ewanuno/ms404_reverse_pot_adapter/ms404 pot adapter kicad project/ms404 pot adapter pcb.kicad_sch

## KiCad design ms404 pot adapter kicad project/ms404 pot adapter pcb.kicad_sch (2024-04-05)

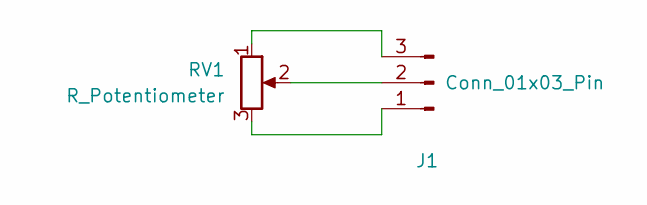
[picture p1: schematic ms404 pot adapter pcb.kicad_sch]

Parts:
J1: Conn_01x03_Pin; PinHeader_1x03_P2.54mm_Vertical
RV1: R_Potentiometer; Potentiometer_Alps_RK163_Single_Horizontal

Connections:
unnamed: J1.1, RV1.3
unnamed: J1.2, RV1.2
unnamed: J1.3, RV1.1
